jlordonezr/WashingMachineSystem/FSM_WashingMachineSystem/BootAnimation.h

#ifndef BOOT_ANIMATION_H
#define BOOT_ANIMATION_H

// Start-up animation bitmaps: a Border Collie chasing a butterfly.
// Adafruit drawBitmap() format: 1 bit per pixel, rows top to bottom, MSB = leftmost pixel.
// The collie's black coat is dithered (every other pixel), the white markings are
// solid. Drawn and approved in the browser preview, then exported 1:1.

#include <Arduino.h>

#define COLLIE_W 47
#define COLLIE_H 31
#define COLLIE_GALLOP_FRAMES 6
#define COLLIE_FRAMES 8
#define FLY_W 19
#define FLY_H 13

// Gallop 1: stretched out in the air
//   
//   
//   
//            ##
//            ##
//           ###
//         ### ##
//        # # # #
//      #### # ##
//    ##### # # ######
//    ###### # # ######             ###
//     ######## #############   ##### #####
//             ######### # # ### # # # # # #       #
//             ######## # # # # # # # # # # ########
//            ########## # # # # # # # # # # # # ###
//            ######### # # # # # # # # # ##### ####
//            ########## # # # # # # # # ##   #####
//              ####### # # # ####### # # ##
//             ########### # #  #   ## # # ##
//            ##########             ## # # ##
//          ########                   # # # ###
//        #########                    ## # # # ###
//     ##########                      # # # # # ###
//   ##########                         ### # ######
//   #########                             # ##  ###
//     ####                                 ####
//                                            ###
//                                              ####
//                                                ##
//   
//   
static const uint8_t collieFrame0[] PROGMEM = {
  0x00, 0x00, 0x00, 0x00, 0x00, 0x00,
  0x00, 0x00, 0x00, 0x00, 0x00, 0x00,
  0x00, 0x00, 0x00, 0x00, 0x00, 0x00,
  0x00, 0x60, 0x00, 0x00, 0x00, 0x00,
  0x00, 0x60, 0x00, 0x00, 0x00, 0x00,
  0x00, 0xE0, 0x00, 0x00, 0x00, 0x00,
  0x03, 0xB0, 0x00, 0x00, 0x00, 0x00,
  0x05, 0x50, 0x00, 0x00, 0x00, 0x00,
  0x1E, 0xB0, 0x00, 0x00, 0x00, 0x00,
  0x7D, 0x5F, 0x80, 0x00, 0x00, 0x00,
  0x7E, 0xAF, 0xC0, 0x01, 0xC0, 0x00,
  0x3F, 0xDF, 0xFF, 0x1F, 0x7C, 0x00,
  0x00, 0x3F, 0xEA, 0xEA, 0xAA, 0x02,
  0x00, 0x3F, 0xD5, 0x55, 0x55, 0xFE,
  0x00, 0x7F, 0xEA, 0xAA, 0xAA, 0xAE,
  0x00, 0x7F, 0xD5, 0x55, 0x57, 0xDE,
  0x00, 0x7F, 0xEA, 0xAA, 0xAC, 0x7C,
  0x00, 0x1F, 0xD5, 0x7F, 0x56, 0x00,
  0x00, 0x3F, 0xFA, 0x91, 0xAB, 0x00,
  0x00, 0x7F, 0xE0, 0x00, 0xD5, 0x80,
  0x01, 0xFE, 0x00, 0x00, 0x2A, 0xE0,
  0x07, 0xFC, 0x00, 0x00, 0x35, 0x5C,
  0x3F, 0xF0, 0x00, 0x00, 0x2A, 0xAE,
  0xFF, 0xC0, 0x00, 0x00, 0x1D, 0x7E,
  0xFF, 0x80, 0x00, 0x00, 0x02, 0xCE,
  0x3C, 0x00, 0x00, 0x00, 0x01, 0xE0,
  0x00, 0x00, 0x00, 0x00, 0x00, 0x70,
  0x00, 0x00, 0x00, 0x00, 0x00, 0x1E,
  0x00, 0x00, 0x00, 0x00, 0x00, 0x06,
  0x00, 0x00, 0x00, 0x00, 0x00, 0x00,
  0x00, 0x00, 0x00, 0x00, 0x00, 0x00
};

// Gallop 2: front feet land
//   
//   
//            #
//           ##
//           # #
//         ## ##
//       ### # #
//       ## # # #   #
//     ##### # # ### #            #######
//   ###### # # ##### ############# # # ##        ##
//   ####### # ####### # # # # # # # # # ###     ###
//      ############### # # # # # # # # # # ########
//             ####### # # # # # # # # # # # # ####
//            ######### # # # # # # # # # # ######
//            ########## # # # # # # # # # #
//            ######### # # ####### # # # # #
//              ######## # #  # #  # # # # # #
//               ########          ## # # # # ##
//              #######            # # # ##########
//             #### ##             ## # ## #   #####
//           ####### #              ## # #        #
//          #### ####               # # # #
//        ####   ####                ### # ##
//     #####     ####                   # # ##
//               ####                    ########
//               ####                      #######
//               ####                         ####
//               ###
//               ###
//              ####
//             ####
static const uint8_t collieFrame1[] PROGMEM = {
  0x00, 0x00, 0x00, 0x00, 0x00, 0x00,
  0x00, 0x00, 0x00, 0x00, 0x00, 0x00,
  0x00, 0x40, 0x00, 0x00, 0x00, 0x00,
  0x00, 0xC0, 0x00, 0x00, 0x00, 0x00,
  0x00, 0xA0, 0x00, 0x00, 0x00, 0x00,
  0x03, 0x60, 0x00, 0x00, 0x00, 0x00,
  0x0E, 0xA0, 0x00, 0x00, 0x00, 0x00,
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
  0x01, 0x10, 0x00,
  0xF0, 0xA1, 0xE0,
  0x7C, 0x47, 0xC0,
  0x7E, 0x4F, 0xC0,
  0x3F, 0xFF, 0x80,
  0x1F, 0xFF, 0x00,
  0x1F, 0xFF, 0x00,
  0x03, 0xF8, 0x00,
  0x07, 0xFC, 0x00,
  0x0F, 0xFE, 0x00,
  0x0F, 0xFE, 0x00,
  0x02, 0x08, 0x00,
  0x02, 0x08, 0x00
};

// Butterfly: wings half open
//          #   #
//       ##  # #  ##
//       ###  #  ###
//       ###########
//        #########
//        #########
//        #########
//          #####
//         #######
//         #######
//         #######
//          #   #
//   
static const uint8_t flyFrame1[] PROGMEM = {
  0x01, 0x10, 0x00,
  0x0C, 0xA6, 0x00,
  0x0E, 0x4E, 0x00,
  0x0F, 0xFE, 0x00,
  0x07, 0xFC, 0x00,
  0x07, 0xFC, 0x00,
  0x07, 0xFC, 0x00,
  0x01, 0xF0, 0x00,
  0x03, 0xF8, 0x00,
  0x03, 0xF8, 0x00,
  0x03, 0xF8, 0x00,
  0x01, 0x10, 0x00,
  0x00, 0x00, 0x00
};

// Butterfly: wings closed
//          #   #
//          ## ##
//           ###
//           ###
//           ###
//           ###
//           ###
//           ###
//           ###
//           ###
//           ###
//   
//   
static const uint8_t flyFrame2[] PROGMEM = {
  0x01, 0x10, 0x00,
  0x01, 0xB0, 0x00,
  0x00, 0xE0, 0x00,
  0x00, 0xE0, 0x00,
  0x00, 0xE0, 0x00,
  0x00, 0xE0, 0x00,
  0x00, 0xE0, 0x00,
  0x00, 0xE0, 0x00,
  0x00, 0xE0, 0x00,
  0x00, 0xE0, 0x00,
  0x00, 0xE0, 0x00,
  0x00, 0x00, 0x00,
  0x00, 0x00, 0x00
};

static const uint8_t* const collieFrames[COLLIE_FRAMES] = {
  collieFrame0, collieFrame1, collieFrame2, collieFrame3, collieFrame4, collieFrame5, collieFrame6, collieFrame7
};
static const uint8_t* const flyFrames[4] = { flyFrame0, flyFrame1, flyFrame2, flyFrame1 };   // wingbeat: open, half, closed, half

#endif
