jlordonezr/WashingMachineSystem/(commit log)

2026-10-30 Grey water controller firmware 3.1.0
    Firmware 3.1 for the Arduino Nano ESP32 grey-water washing machine controller:
    - Spanish (Colombia, usted) and English for the OLED, the web app and the
    phone alerts, chosen in Settings (Spanish by default)
    - 3.0 safety task and output interlocks, float-switch rules, per-board Wi-Fi
    setup key, confirmed actions in the app, modular code
    - PC tests, full-cycle simulation, browser tests, docs and manuals
    Claude-Session: https://claude.ai/code/session_019mC6G1yoXXYnrTywbsYGtT
2026-10-30 Make the OLED tank-level icon larger and easier to read
    The tank icon grows from 13x9 to 17x10 px (full header height) and gets
    half-way marks so an empty tank still reads as a tank. The wash-valve
    icon narrows to 11 px to make room; titles still fit in 96 px.
2026-10-30 Add Border Collie start-up animation on the OLED
    After power-on a Border Collie chases a butterfly across the full screen
    (about 4 s: gallop in, herding stalk, sprint off), then "System ready"
    shows for 2 s as before. Bitmaps (BootAnimation.h, ~1.6 KB) were drawn
    in the browser preview and exported 1:1; the black coat is dithered and
    the white markings are solid.
    Notices that arrive during the animation (Wi-Fi address, setup key,
    interrupted cycle) are held and shown after "System ready". Start or a
    tank wash ends the animation at once. Without a screen it is skipped.
    Simulation stubs gain drawBitmap/drawPixel/PROGMEM; scenario F4b waits
    for the animation before checking the INTERRUPTED no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
    [Arduino.h, BootAnimation.h, FSM_WashingMachineSystem.ino, GreyWaterDisplay.cpp, GreyWaterSystem.h, test_cycle.cpp]
2026-10-30 Firmware 3.2.0: buzzer on D1, manuals rebuilt from editable sources
    - Optional buzzer moved from D12 to D1 (TX0). setup() drives it LOW
    first thing; the chip's boot messages on TX0 can still make it chirp
    briefly at power-on, which is documented as normal.
    - FIRMWARE_VERSION 3.2.0 (rename, start-up animation, Helvetica Bold
    screen font, larger tank icon, buzzer pin). App Settings hint and its
    Spanish text say D1 (TX0); DashboardPage.h rebuilt.
    - README "What's new in 3.2"; ARCHITECTURE, INSTALL, PROTOCOL and
    TESTING updated (new hardware checks H11 start-up screen, H12 buzzer).
    - Runbook and Quick Card rebuilt from HTML sources in manuals/src
    (pinout and buzzer wiring as inline S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
    [FSM_WashingMachineSystem.ino, GreyWaterNet.h, GreyWaterSystem.h]
2026-11-03 Firmware 3.3.0: paged screen messages, reliable phone alerts
    Screen (OLED 128x32): messages now come in short pages that change every
    3 s (what is happening, what it means, what to do), in the large bold
    font. Steps are named in words (LAVADO 1 DE 4 / WASH 1 OF 4), the Ready
    screen shows the tank level, steps 1-3 show the minutes left from the
    second wash, and the end screen shows litres reused and saved.
    check_screen_text.py measures every page; simulation checks the new
    screens.
    Phone alerts (ntfy): failure codes no longer clash with HTTPClient's
    (-2/-3 were misreported as "no Wi-Fi" / "bad server address"); up to 3
    tries per alert, 5 min wait for Wi-Fi, 10 s network timeouts; topic
    valid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
    [GreyWaterDisplay.cpp, GreyWaterNet.cpp, GreyWaterNet.h, GreyWaterSystem.cpp, GreyWaterSystem.h, Ntfy.h]
2026-11-03 Firmware 3.3.1: alerts retried for 30 min during an outage
    The public ntfy.sh server was unreachable for hours; 3.3.0 gave a real
    alert only 3 tries in about 15 s. Failed alerts (no Wi-Fi, no answer,
    timeout, 408, 429, 5xx) now wait in up to 6 slots, each on its own
    schedule (5 s, 10 s, 20 s ... then every 5 min), for up to 30 min. The
    test alert still gives up after 30 s so the app answers in time.
    App: the subscribe link no longer repeats a topic pasted into Alert
    server. Runbook (troubleshooting, alerts, history), Quick Card and docs
    updated; PDFs rebuilt; test_ntfy.cpp covers the retry rule (31 checks).
    [GreyWaterNet.cpp, GreyWaterNet.h, Ntfy.h, test_ntfy.cpp]
2026-11-04 Firmware 3.4.0: minimum flow to save, screen font chosen in Settings
    Step 4 saves rinse water to the tank only while the drain flow is above
    the new setting "Minimum flow to save" (default 0.5 L/min, 0.5-10). At or
    below it the fill valve closes and the drain opens on the same pass, so
    the last trickle goes to the drain; a new pump-out is saved again after
    2 s above the limit. The tank-full alert now fires only when the tank is
    full (it fired whenever step 4 was not saving). Simulation F13.
    Settings -> Screen -> Screen font: the original Helvetica Bold or five
    13 px styles (narrow bold, narrow light, semi-narrow, round, classic
    serif), applied at once. Fonts built by tools/make_screen_fonts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
2026-11-04 Screen: shorter messages without repeating the top line; full brightness
    Each message now says what is happening in one or two parts and leaves
    out what the top line or the icons already show: Ready "Inicie lavadora
    > y pulse START" (no tank-level part), "Esperando agua", "Reusando agua",
    "Desaguando > agua jabonosa", "Agua al tanque > Fin en 18:42", DONE
    "Reusados 26 L > Guardados 30 L", STOPPED "Ciclo cancelado", no flow
    "Sin flujo > Revise lavadora > Pida ayuda", and so on (127 texts and
    pages, all fit). The OLED runs at full contrast (255 instead of 207).
    Simulation F1/F12 expectations, Runbook, Quick Card, README and TESTING
    updated; PDFs rebuilt.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
    [GreyWaterDisplay.cpp, GreyWaterNet.cpp, GreyWaterSystem.cpp, test_cycle.cpp]
2026-11-04 Firmware 3.4.1: version for the shorter screen messages and full brightness
    The build uploaded after 81ad39c still reported 3.4.0. FIRMWARE_VERSION
    is now 3.4.1; README, Runbook (version, revision history) and Quick Card
    list 3.4.1 separately from 3.4.0. PDFs rebuilt. No code change otherwise.
    [GreyWaterNet.h]
